jun1okamura/TR-1um_C4004_Template/reference/09_work_memo.md

# C4004 作業メモ・調査記録 (`09_work_memo.md`)

作成・更新: 2026-11-05  
対象プロジェクト: `TR-1um_C4004`  
使用PDK: https://github.com/OpenSUSI/TR-1um (`TR-1um/`)

---
