jun1okamura/TR-1um_C4004_Template/module/STDCELL/simulation/BUFTH.spice

* BUFTH — LVS ソースネットリスト
* **手で作った正本。生成器は無い**（2026-09-17 に確認。U66）。
* 2026-09-17 まで「scripts/char/mkcellspice.py が生成。手で編集しないこと」と
* 名乗っていたが、その生成器は 4 リポジトリのどこにも無かった。
* 直したら `apr/lvs_pdk.py`（PDK の LVS デッキ）で確かめること。
*
* 出どころ: **レイアウト抽出を golden として凍結したもの**。
*   このセルは同じ論理でも CMOS 構造が一意に決まらない（回路図が無い）。
*   10T。W(P) を 5.1/10.2 で使い分けた閾値付きバッファ。
*
*   ** この .spice に対する LVS は「レイアウト vs そのレイアウトから作った網」
*      なので、今この瞬間は何も証明しない。意味があるのは
*      次にレイアウトを触ったときに差分が出ること（回帰検査）。**
*
*   凍結した時点で ngspice により機能を確認済み:
*   真理値表 436 点 / 順序 87 点 すべて PASS（scripts/char/RESULTS.txt）。
*
.subckt BUFTH A Y vdd vss
MP0 n3 n2 vss vdd PMOS W=5.1u L=1.0u
MP1 n3 n2 vss vdd PMOS W=5.1u L=1.0u
MP2 vdd n2 Y vdd PMOS W=10.2u L=1.0u
MP3 n3 A n2 vdd PMOS W=5.1u L=1.0u
MP4 vdd A n3 vdd PMOS W=5.1u L=1.0u
MN0 vss n2 Y vss NMOS W=3.4u L=1.0u
MN1 n2 A n1 vss NMOS W=3.4u L=1.0u
MN2 n1 A vss vss NMOS W=3.4u L=1.0u
MN3 vdd n2 n1 vss NMOS W=3.4u L=1.0u
MN4 vdd n2 n1 vss NMOS W=3.4u L=1.0u
.ends BUFTH
