jun1okamura/TR-1um_C4004_Template/module/STDCELL/simulation/DEL1.spice

* DEL1 — LVS ソースネットリスト
* **手で作った正本。生成器は無い**（2026-09-17 に確認。U66）。
* 2026-09-17 まで「scripts/char/mkcellspice.py が生成。手で編集しないこと」と
* 名乗っていたが、その生成器は 4 リポジトリのどこにも無かった。
* 直したら `apr/lvs_pdk.py`（PDK の LVS デッキ）で確かめること。
*
* 出どころ: **レイアウト抽出を golden として凍結したもの**。
*   このセルは同じ論理でも CMOS 構造が一意に決まらない（回路図が無い）。
*   10T。遅延段 4 個だけ L=2.0u にして遅らせている。
*
*   ** この .spice に対する LVS は「レイアウト vs そのレイアウトから作った網」
*      なので、今この瞬間は何も証明しない。意味があるのは
*      次にレイアウトを触ったときに差分が出ること（回帰検査）。**
*
*   凍結した時点で ngspice により機能を確認済み:
*   真理値表 436 点 / 順序 87 点 すべて PASS（scripts/char/RESULTS.txt）。
*
.subckt DEL1 Y A vdd vss
MP0 vdd n1 n2 vdd PMOS W=10.2u L=2.0u
MP1 vdd n2 Y vdd PMOS W=10.2u L=1.0u
MP2 vdd n2 Y vdd PMOS W=10.2u L=1.0u
MP3 vdd A n3 vdd PMOS W=10.2u L=1.0u
MP4 vdd n3 n1 vdd PMOS W=10.2u L=2.0u
MN0 n2 n1 vss vss NMOS W=3.4u L=2.0u
MN1 vss n2 Y vss NMOS W=3.4u L=1.0u
MN2 vss n2 Y vss NMOS W=3.4u L=1.0u
MN3 n3 A vss vss NMOS W=3.4u L=1.0u
MN4 n1 n3 vss vss NMOS W=3.4u L=2.0u
.ends DEL1
